syauqi-alias/pico-peltier/README.md

# pico-peltier
A TEC Controller using Pico RP2350 with Analog Devices LT8722 full bridge driver rated at 15V 4A

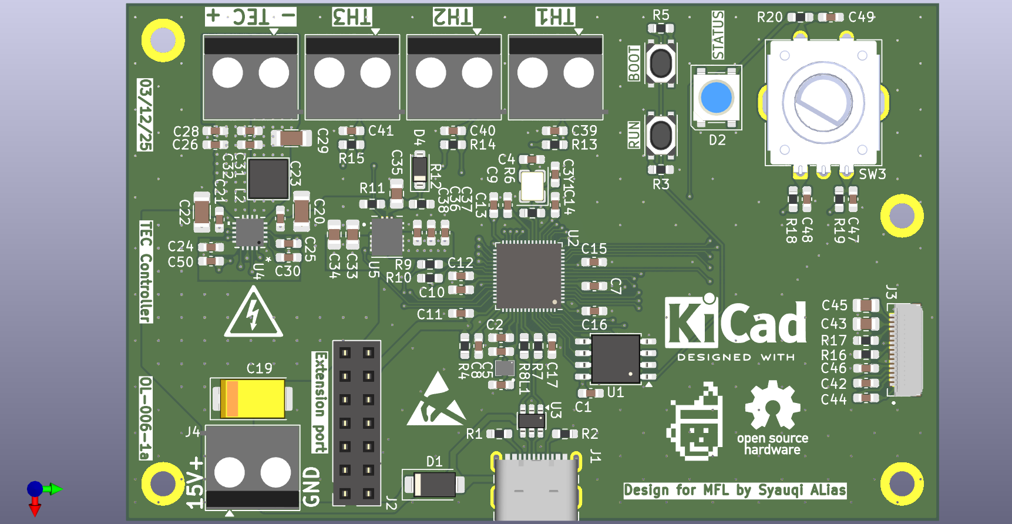
[picture p1: pico_peltier.png]
}Prototype rendered
