syauqi-alias/pico-peltier/analog device demo dc3145a/715-DC3145A_REV3_WEB_BOM.XLSX

 |  |  | DEMO BOARD DC3145A
REQUIRED CIRCUIT COMPONENTS
ITEM | QTY | REFERENCE | DESCRIPTION | SUGGESTED MANUFACTURER, P/N | BOM Notes
1 | 2 | CIN1,CIN2 | CAP.,22uF,ALUM,25V,20%,SMD 6.3x5.8mm | Wurth/875105544003
2 | 1 | C1 | CAP.,47uF,TANT.,20V,20%,7343,TAJD, NO SUBS. ALLOWED | AVX/TAJD476M020RNJ
3 | 4 | C2,CIN3,C9,C15 | CAP.,4.7uF,X7R,25V,10%,1206 | AVX/12063C475KAT2A MURATA/GRM31CR71E475KA88L NIC/NMC1206X7R475K25TRPF TAIYO YUDEN/TMK316AB7475KL-T
4 | 2 | C3,C8 | CAP.,0.1uF,X5R,25V,10%,0402 | AVX/04023D104KAT2A SAMSUNG/CL05A104KA5NNNC TDK/C1005X5R1E104K050BC
5 | 3 | C4,CIN4,C5 | CAP.,1uF,X7R,25V,10%,0603,AEC-Q200 | MURATA/GCM188R71E105KA64D
6 | 1 | C10 | CAP.,0.1uF,X7R,25V,10%,0603,AEC-Q200 | AVX/06033C104K4T4A SAMSUNG/CL10B104KA8WPNC
7 | 1 | C11 | CAP.,1000pF,X7R,25V,10%,0603 | AVX/06033C102KAT2A AVX/06033C102KAT4A KEMET/C0603C102K3RACTU MURATA/GRM188R71E102KA01D NIC/NMC0603X7R102K25TRPF
8 | 3 | C12,C13,C14 | CAP.,0.047uF,X7R,25V,10%,0603 | AVX/06033C473KAT2A MURATA/GRM188R71E473KA01D NIC/NMC0603X7R473K25TRPF
9 | 1 | LB1 | LABEL SPEC, DEMO BOARD SERIAL NUMBER | BRADY/THT-96-717-10
10 | 1 | L1 | IND.,1.0uH,POWER,20%,12A,9.0mOHMS,4.3mmX4.3mm,AEC-Q200 | COILCRAFT/XGL4020-102MEC
11 | 1 | PCB1 | PCB, DC3145A | ADI APPROVED SUPPLIER/600-DC3145A
12 | 1 | R1 | RES.,1k OHM,5%,1/10W,0603,AEC-Q200 | VISHAY/CRCW06031K00JNEA
13 | 1 | R2 | RES.,10 OHMS,5%,1/10W,0603,AEC-Q200 | PANASONIC/ERJ3GEYJ100V VISHAY/CRCW060310R0JNEA
14 | 1 | R3 | RES.,20k OHMS,1%,1/10W,0603 | NIC/NRC06F2002TRF PANASONIC/ERJ3EKF2002V VISHAY/CRCW060320K0FKEA YAGEO/RC0603FR-0720KL
15 | 2 | R5,R6 | RES.,100k OHMS,5%,1/10W,0603,AEC-Q200 | NIC/NRC06J104TRF
16 | 1 | STNCL1 | TOOL, STENCIL, 700-DC3145A | ADI APPROVED SUPPLIER/830-DC3145A
17 | 1 | U1 | IC,15V, 4A MONOLITHIC THERMOELECTRIC COOLER CONTROLLER | ANALOG DEVICES/LT8722AV#PBF
18 | 2 | XJP1,XJP2 | CONN.,SHUNT,FEMALE,2 POS,2mm | Wurth/60800213421
ADDITIONAL DEMO BOARD CIRCUIT COMPONENTS
ITEM | QTY | REFERENCE | DESCRIPTION | SUGGESTED MANUFACTURER, P/N | BOM Notes
1 | 0 | CIN5,C7,C16,C17 | CAP., OPTION, 0603
2 | 0 | D1,D2 | DIODE, OPTION, SOD-323
3 | 0 | R4 | RES.,100 OHMS,5%,5W,20.47mm X 10.31mm | OHMITE/RW5S0FA100RJE
4 | 0 | R7 | RES., OPTION, 0603
HARDWARE
ITEM | QTY | REFERENCE | DESCRIPTION | SUGGESTED MANUFACTURER, P/N | BOM Notes
1 | 6 | E1,E2,E3,E4,E5,E6 | TEST POINT,TURRET,0.094" MTG. HOLE,PCB 0.062" THK | MILL-MAX/2501-2-00-80-00-00-07-0
2 | 15 | E7,E8,E9,E10,E11,E12,E13,E14,E15,E16,E17,E18,E19,E20,E21 | TEST POINT,SILVER PLATE,PHOSPHOR BRONZE,3.81mmX2.03mm,2.29mm H,SMT | KEYSTONE/5019
3 | 4 | J1,J2,J3,J4 | CONN.,BANANA JACK,FEMALE,THT,NON-INSULATED,SWAGE,0.218" | KEYSTONE/575-4
4 | 2 | JP1,JP3 | CONN.,HDR,MALE,1x3,2mm,VERT,ST,THT,NO SUBS. ALLOWED | Wurth/62000311121
5 | 1 | JP2 | CONN.,HDR,SHROUDED,PLUG,MALE,2x7,2mm,VERT,ST,THT,KEYED | MOLEX/87831-1420
6 | 4 | MP1,MP2,MP3,MP4 | STANDOFF,NYLON,SNAP-ON,0.50" | KEYSTONE/8833
