syauqi-alias/pico-peltier/pico_peltier_mouser.xls

Mfr Part Number (Input) | Manufacturer Part Number | Mouser Part Number | Manufacturer Name | Description | Quantity 1 | Unit Price 1 | Quantity 2 | Unit Price 2 | Quantity 3 | Unit Price 3 | Quantity 4 | Unit Price 4 | Quantity 5 | Unit Price 5 | Order Quantity | Order Unit Price | Min./Mult. | Availability | Lead Time in Days | Lifecycle | NCNR | RoHS | Pb Free | Package Type | Datasheet URL | Product Image | Design Risk
 |  | 581-KGM15AR70J104KM |  |  | 18
 |  | 81-GRM188Z71A475KE5D |  |  | 4
 |  | 603-CC603FRNPO9BN150 |  |  | 2
 |  | 581-TAJD476M020R |  |  | 1
 |  | 581-12063C475KAT2A |  |  | 3
 |  | 187-CL10A104KA8NNNC |  |  | 6
 |  | 81-GCJ188R71E473KA1D |  |  | 3
 |  | 81-GCM188R71E105KA4D |  |  | 2
 |  | 187-CL21A106KAYNNNE |  |  | 1
 |  | 581-08053D104KAT2A |  |  | 1
 |  | KGM21NR71E103KT |  |  | 1
 |  | 581-KAM15CT70J226KT |  |  | 2
 |  | 81-GCM188R71E105KA4D |  |  | 2
 |  | 187-CL21A106KAYNNNE |  |  | 2
 |  | 625-SS12-E3 |  |  | 1
 |  | 474-COM-24837 |  |  | 1
 |  | 640-USB4105-GF-A |  |  | 1
 |  | 571-5-534236-7 |  |  | 1
 |  | 649-311A7H121016E200 |  |  | 1
 |  | 845-30.002 |  |  | 2
 |  | 815-AB201610S3R3101T |  |  | 1
 |  | 994-XAL4020-102MEC |  |  | 1
 |  | 652-CR0603FX-5101ELF |  |  | 3
 |  | 603-RC0603FR-101KL |  |  | 3
 |  | 279-CRGCQ0603F33R |  |  | 1
 |  | 603-RC0603FR-1327RL |  |  | 2
 |  | 71-CRCW0603-20K-E3 |  |  | 1
 |  | 660-SG73P1JTTD1003F |  |  | 1
 |  | 667-ERJ-3EKF8662V |  |  | 1
 |  | 71-CRCW060310K0FKEE |  |  | 4
 |  | 603-RT0603WRE0710KL |  |  | 3
 |  | 71-CRCW0603680KFKEAH |  |  | 1
 |  | 710-434133025816 |  |  | 2
 |  | 652-PEC12R3220FS0024 |  |  | 1
 |  | 845-30.002 |  |  | 3
 |  | 454-W25Q128JVSIMTR |  |  | 1
 |  | 358-SC1509 |  |  | 1
 |  | 710-82400102 |  |  | 1
 |  | 584-LT8722AVPBF |  |  | 1
 |  | 595-TPSM863253RDXR |  |  | 1
 |  | 815-ABM8-272-T3 |  |  | 1
