syauqi-alias/pico-peltier/plots/pico_peltier__Assembly.pdf

J3 | H1 U5 C36 1 | 2 | 3 | 4 | 5 | 6 1 | 2 | 3 | 4 | 5 | 6 ABCD | ABCD Date: KiCad E.D.A. 9.0.6 Size: A4 | Rev:

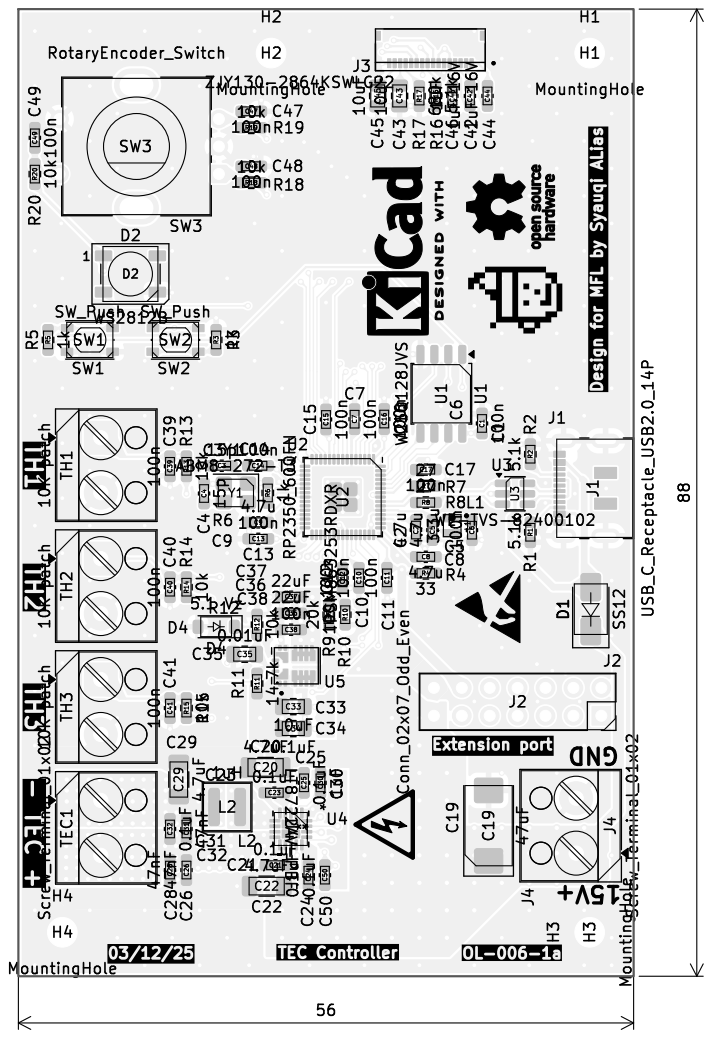
[picture p2: page 1]

Id: /1 Title: File: pico_peltier.kicad_pcb Sheet: Black And White TOP

1 | 2 | 3 | 4 | 5 | 6

A

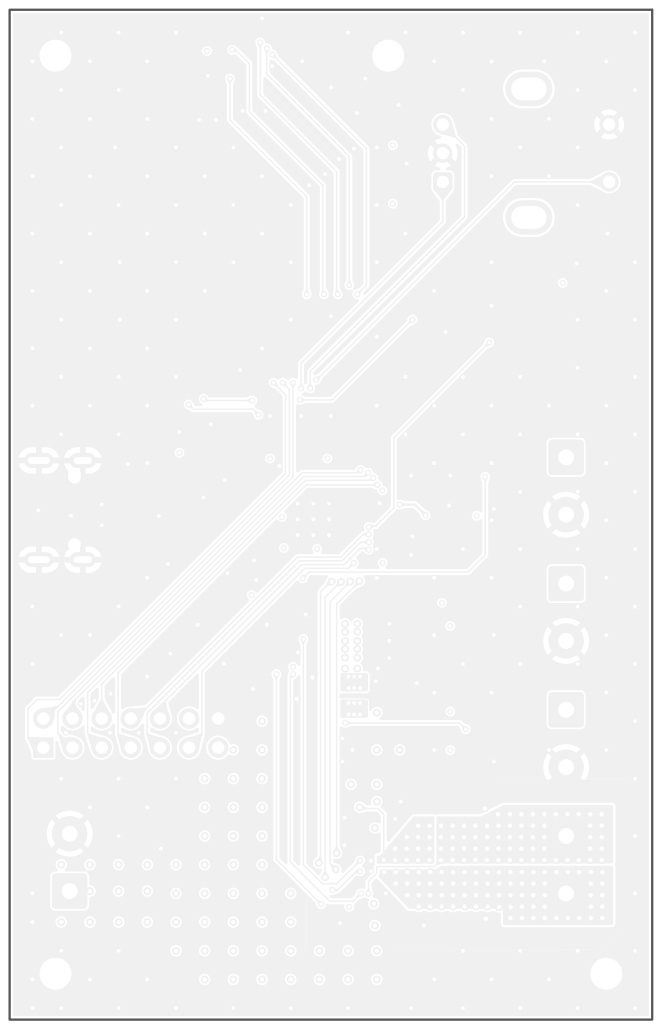
[picture p3: page 2]
D Date: KiCad; E.D.A. 9.0.6 Size: A4; Rev:; Id: /1 Title: File: pico_peltier.kicad_pcb Sheet: Black; And; White; BOT Board2Pdf:; Black; BOT -; Page 2/2
