syauqi-alias/pico-peltier/analog device demo dc3145a/705-DC3145A_REV3_PCA_ASSY_DWG_BOTTOM.PDF

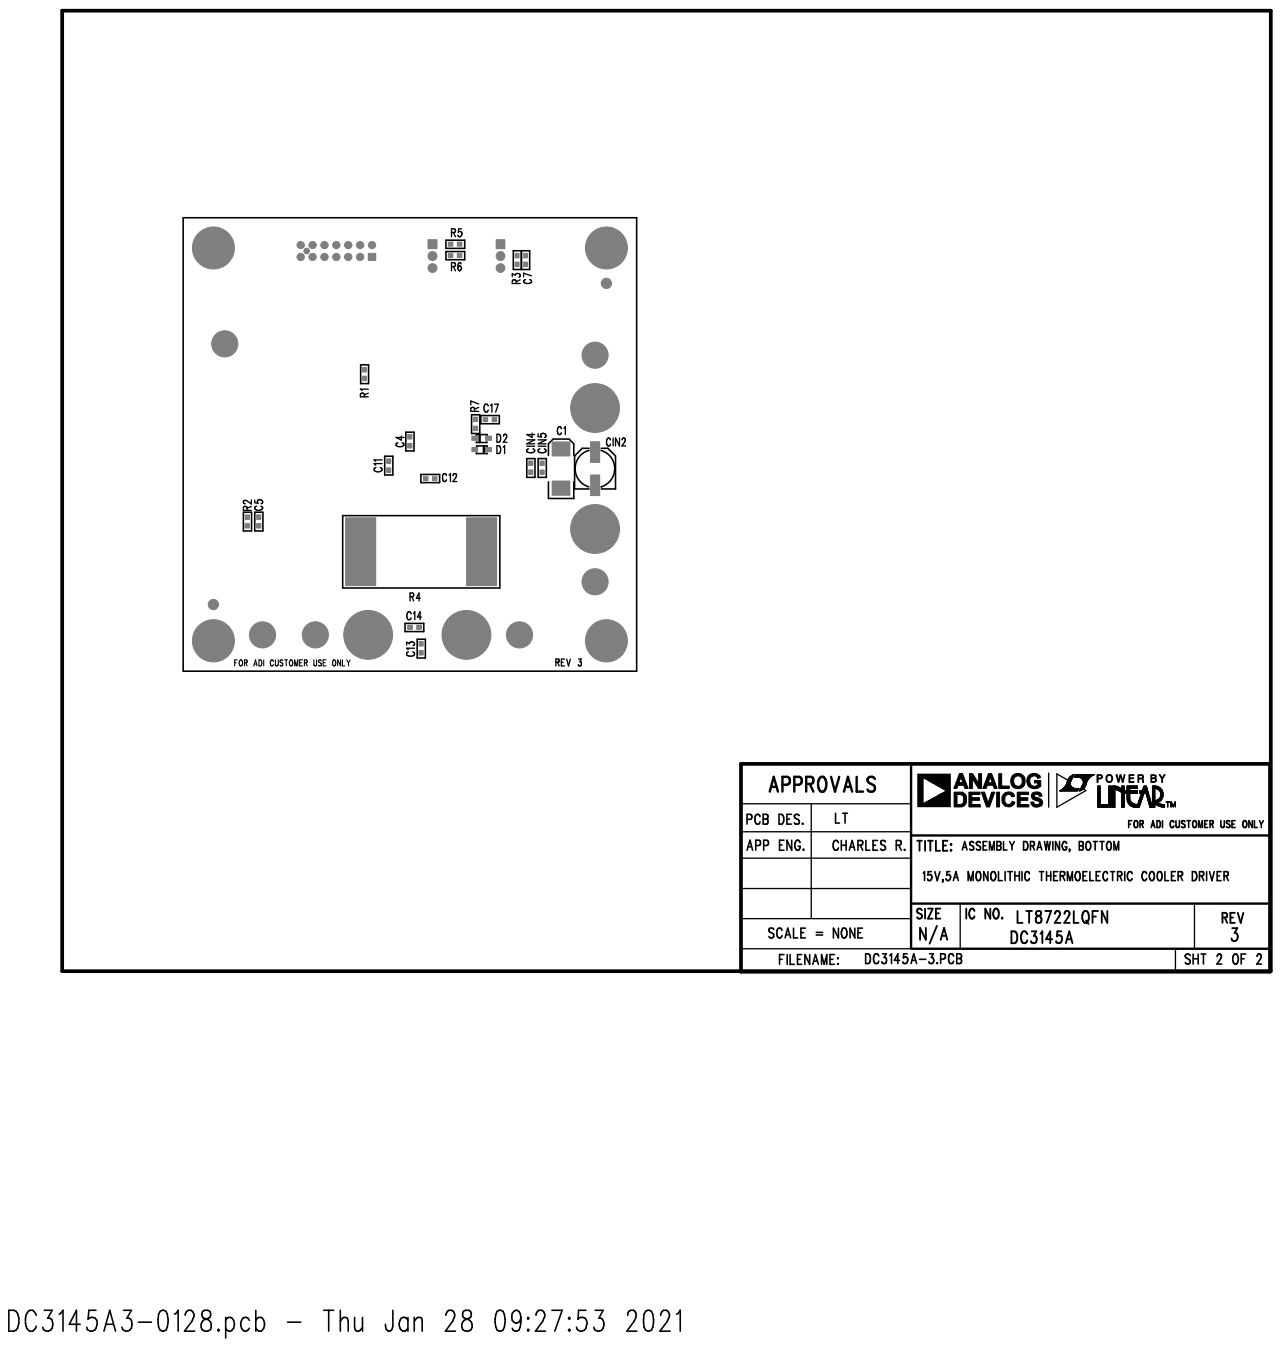
[picture p11: page 1]
