syauqi-alias/pico-peltier/analog device demo dc3145a/705-DC3145A_REV3_PCA_ASSY_DWG_TOP.PDF

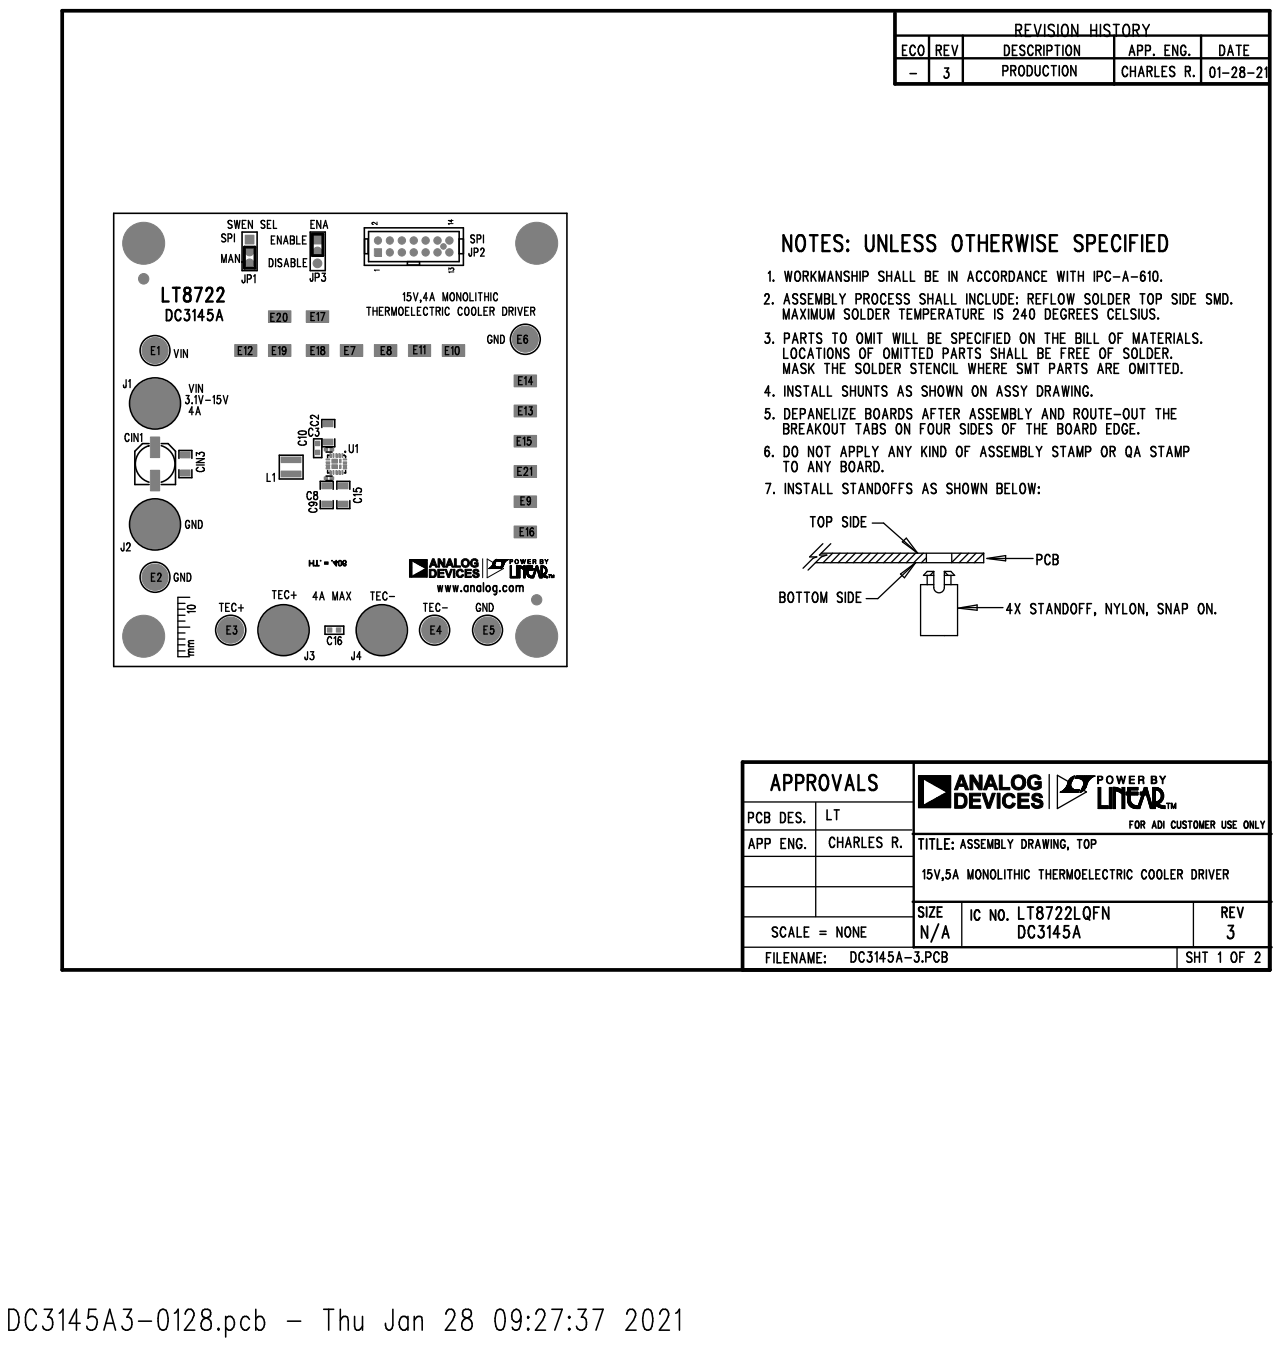
[picture p12: page 1]
