syauqi-alias/pico-peltier/analog device demo dc3145a/610-DC3145A_REV3_GERBER_PDF/DC3145A3-BM.pdf

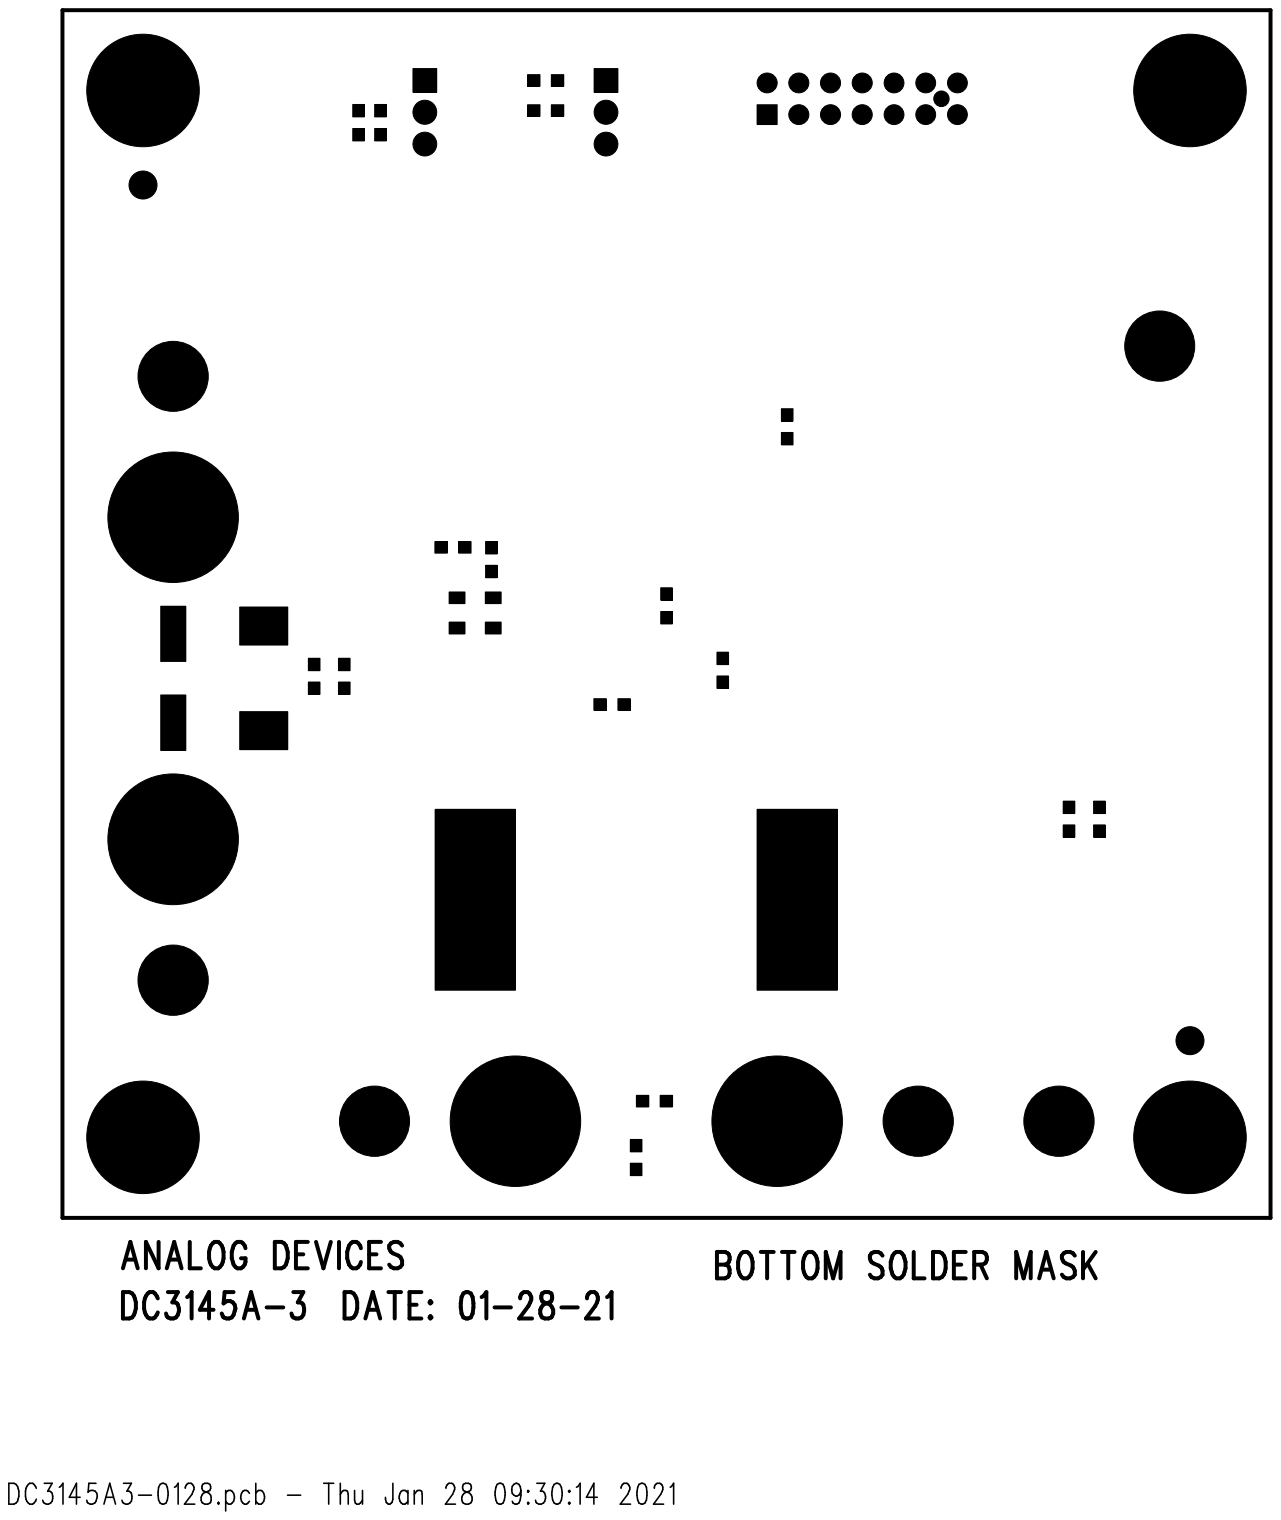
[picture p13: page 1]
