syauqi-alias/pico-peltier/analog device demo dc3145a/610-DC3145A_REV3_GERBER_PDF/DC3145A3-BP.pdf

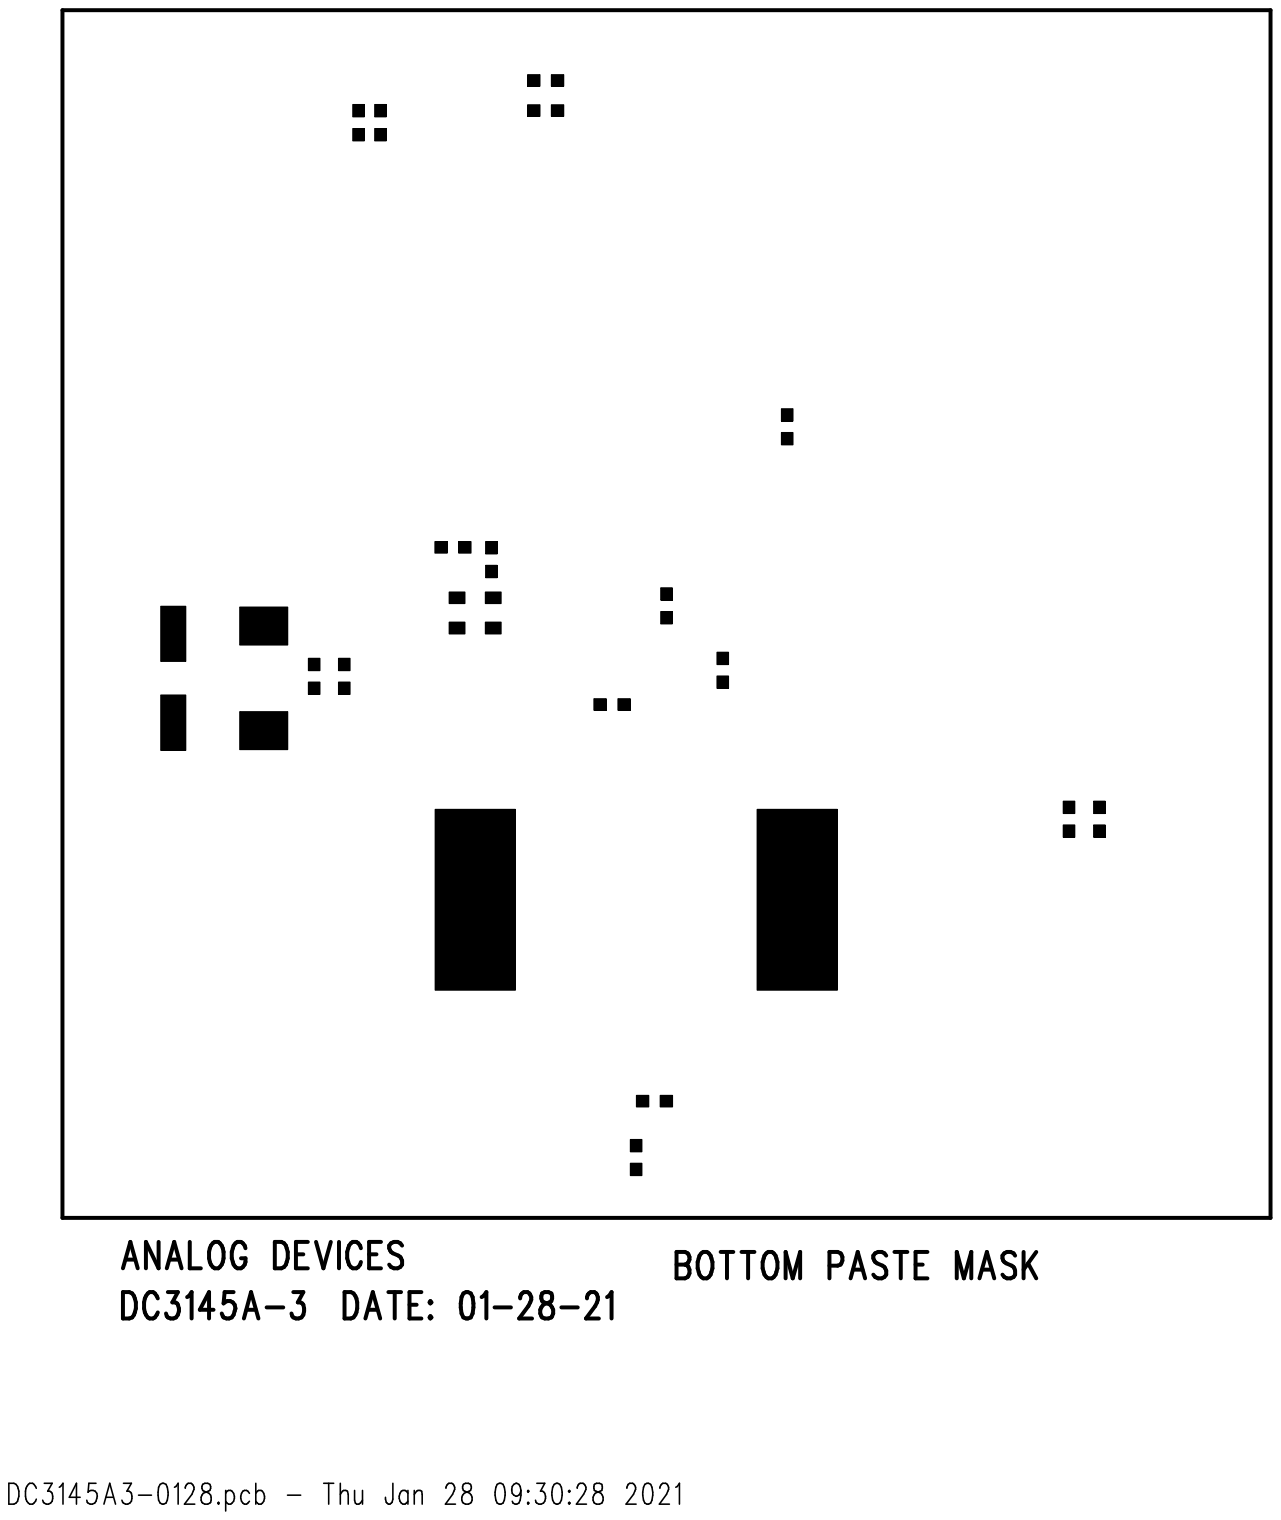
[picture p14: page 1]
