syauqi-alias/pico-peltier/analog device demo dc3145a/610-DC3145A_REV3_GERBER_PDF/DC3145A3-BS.pdf

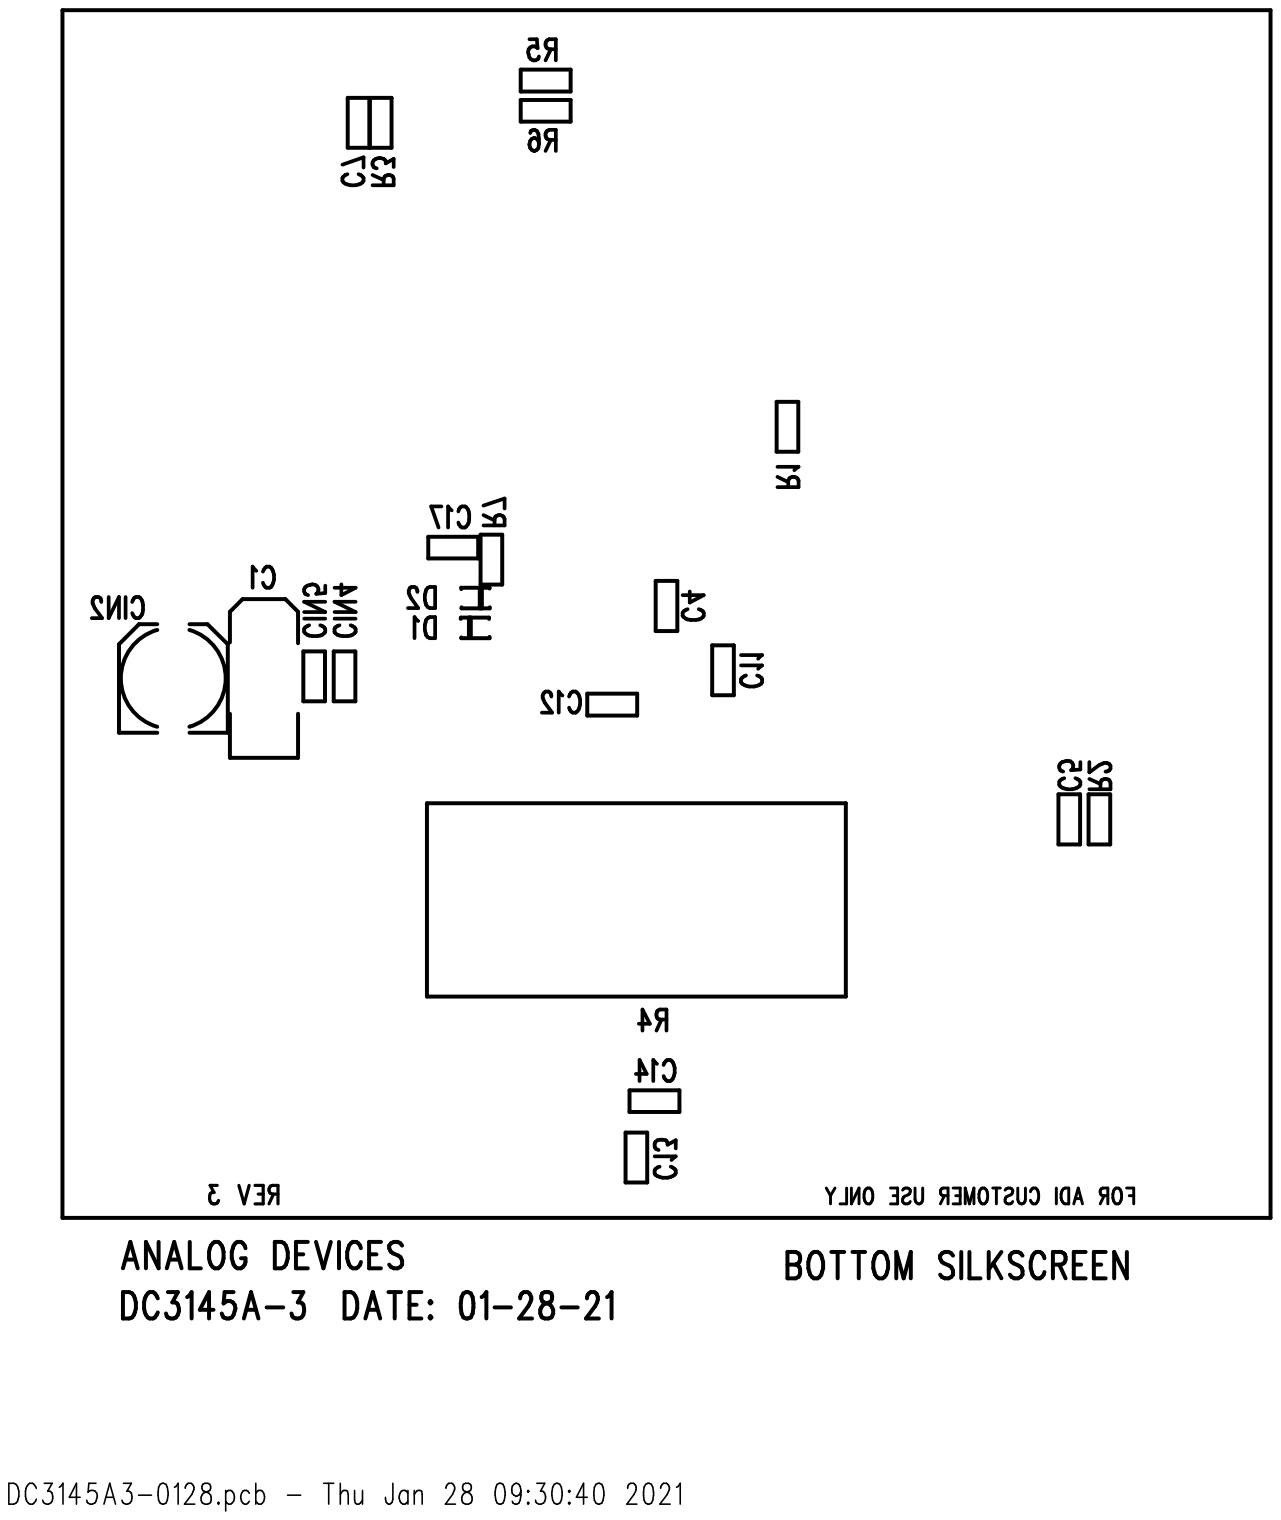
[picture p15: page 1]
