syauqi-alias/pico-peltier/(list of files, drawings)

Other design files:
analog device demo dc3145a/630-DC3145A_REV3_DESIGN_LAYOUT.PCB
analog device demo dc3145a/710-DC3145A_REV3_PCA_SCHEMATIC.DSN
