syauqi-alias/pico-peltier/pico_peltier.kicad_pcb

## KiCad design pico_peltier.kicad_pcb (2025-12-16)

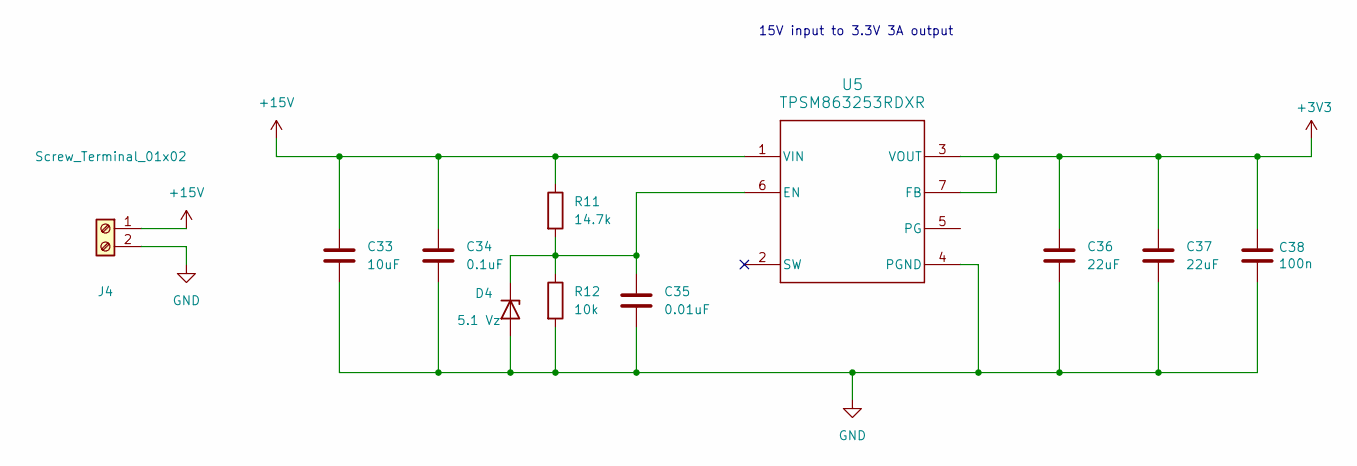
[picture p24: schematic 3v3_psu.kicad_sch, 3.3V Power Supply]

Parts:
C33: 10uF; C_0805_2012Metric_Pad1.18x1.45mm_HandSolder; mouser 187-CL21A106KAYNNNE
C34: 0.1uF; C_0805_2012Metric_Pad1.18x1.45mm_HandSolder; mouser 581-08053D104KAT2A
C35: 0.01uF; C_0805_2012Metric_Pad1.18x1.45mm_HandSolder; mouser KGM21NR71E103KT
C36, C37: 22uF; C_0603_1608Metric_Pad1.08x0.95mm_HandSolder; mouser 581-KAM15CT70J226KT
C38: 100n; C_0603_1608Metric_Pad1.08x0.95mm_HandSolder; mouser 581-KGM15AR70J104KM
D4: 5.1 Vz; D_SOD-123; mouser 621-MMSZ5231B-F
J4: Screw_Terminal_01x02; Altech_AK100_1x02_P5.00mm; mouser 845-30.002
R11: 14.7k; R_0603_1608Metric_Pad0.98x0.95mm_HandSolder; mouser 603-RC0603FR-1014K7L
R12: 10k; R_0603_1608Metric_Pad0.98x0.95mm_HandSolder; mouser 71-CRCW060310K0FKEE
U5: TPSM863253RDXR; VREG_TPSM863253RDXR; mouser 595-TPSM863253RDXR

Connections:
+3V3: C36.1, C37.1, C38.1, U5.3 (VOUT), U5.7 (FB), U5.14 (VOUT), U5.15 (VOUT), U5.16 (VOUT), U5.17 (VOUT), U5.18 (VOUT), U5.19 (VOUT); also elsewhere on the board
+15V: C33.1, C34.1, J4.1, R11.1, U5.1 (VIN); also elsewhere on the board
GND: C33.2, C34.2, C35.2, C36.2, C37.2, C38.2, D4.2 (A), J4.2, R12.2, U5.4 (PGND); also elsewhere on the board
unnamed: C35.1, D4.1 (K), R11.2, R12.1, U5.6 (EN)

Notes on the sheet:
15V input to 3.3V 3A output

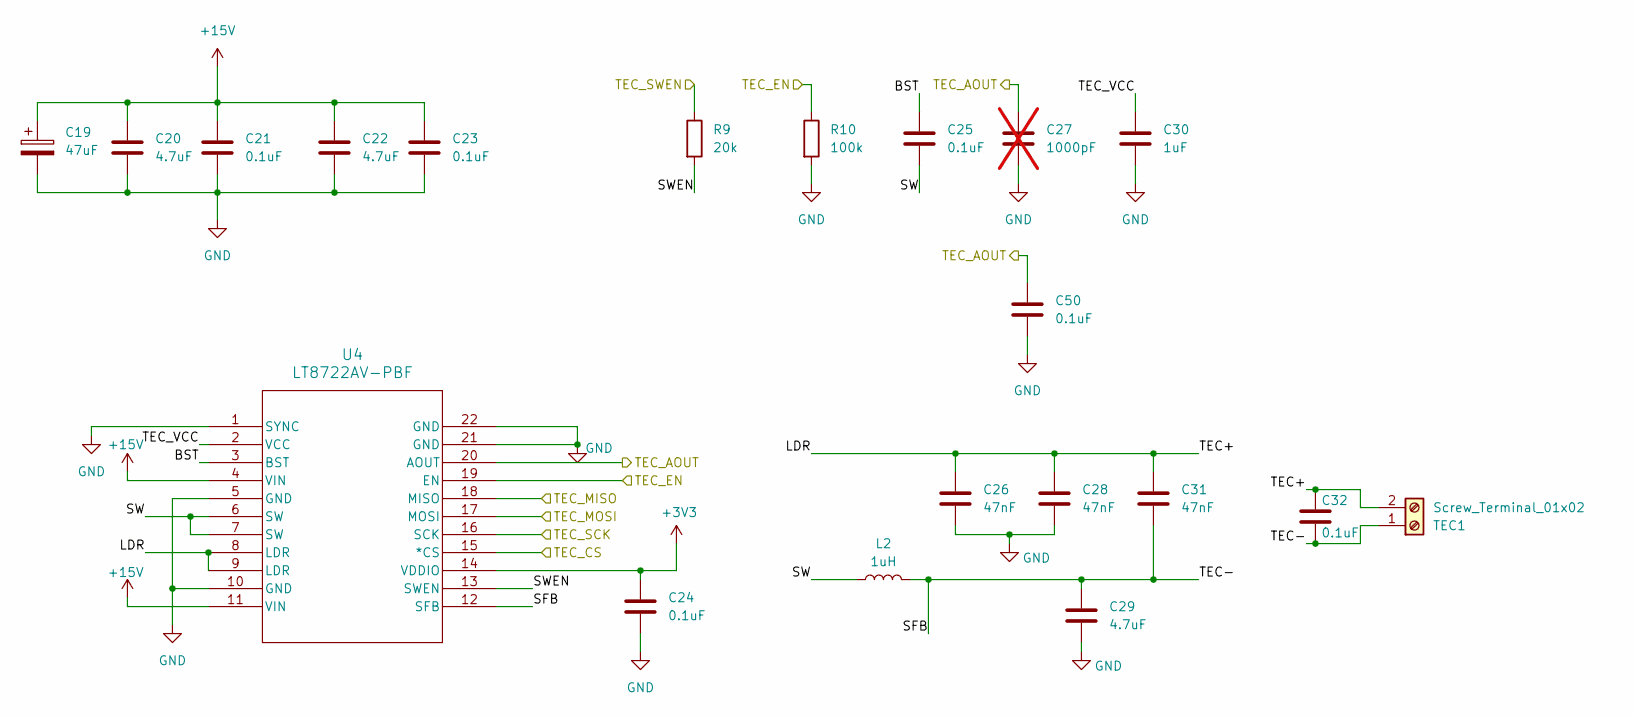
[picture p25: schematic peltier_cont.kicad_sch, LT8722 Half Bridge Driver]

Parts:
C19: 47uF; CP_EIA-7343-31_Kemet-D_HandSolder; mouser 581-TAJD476M020R
C20, C22, C29: 4.7uF; C_1206_3216Metric_Pad1.33x1.80mm_HandSolder; mouser 581-12063C475KAT2A
C21, C23, C24, C25, C32, C50: 0.1uF; C_0603_1608Metric_Pad1.08x0.95mm_HandSolder; mouser 187-CL10A104KA8NNNC
C26, C28, C31: 47nF; C_0603_1608Metric_Pad1.08x0.95mm_HandSolder; mouser 81-GCJ188R71E473KA1D
C27: 1000pF; C_0603_1608Metric_Pad1.08x0.95mm_HandSolder; mouser 581-06033C102KAT2A; not fitted
C30: 1uF; C_0603_1608Metric_Pad1.08x0.95mm_HandSolder; mouser 81-GCM188R71E105KA4D
L2: 1uH; L_Coilcraft_XAL4020-XXX; mouser 994-XAL4020-102MEC
R9: 20k; R_0603_1608Metric_Pad0.98x0.95mm_HandSolder; mouser 71-CRCW0603-20K-E3
R10: 100k; R_0603_1608Metric_Pad0.98x0.95mm_HandSolder; mouser 660-SG73P1JTTD1003F
TEC1: Screw_Terminal_01x02; Altech_AK100_1x02_P5.00mm; mouser 845-30.002
U4: LT8722AV-PBF; LQFN18_3X3X0.95_ADI-M; mouser 584-LT8722AVPBF

Connections:
+3V3: C24.1, U4.14 (VDDIO); also elsewhere on the board
+15V: C19.1, C20.1, C21.1, C22.1, C23.1, U4.4 (VIN), U4.11 (VIN); also elsewhere on the board
/mcu_rp2354a/GPIO20: U4.18 (MISO); also elsewhere on the board
/mcu_rp2354a/GPIO21: U4.16 (SCK); also elsewhere on the board
/mcu_rp2354a/GPIO22: U4.15 (*CS); also elsewhere on the board
/mcu_rp2354a/GPIO23: U4.17 (MOSI); also elsewhere on the board
/mcu_rp2354a/GPIO24: R9.1; also elsewhere on the board
/mcu_rp2354a/GPIO25: R10.1, U4.19 (EN); also elsewhere on the board
/mcu_rp2354a/GPIO29_ADC3: C27.1, C50.1, U4.20 (AOUT); also elsewhere on the board
/peltier_cont/BST: C25.1, U4.3 (BST)
/peltier_cont/LDR: C26.1, C28.1, C31.1, C32.1, TEC1.2, U4.8 (LDR), U4.9 (LDR)
/peltier_cont/SFB: C29.1, C31.2, C32.2, L2.2, TEC1.1, U4.12 (SFB)
/peltier_cont/SW: C25.2, L2.1, U4.6 (SW), U4.7 (SW)
/peltier_cont/SWEN: R9.2, U4.13 (SWEN)
/peltier_cont/TEC_VCC: C30.1, U4.2 (VCC)
GND: C19.2, C20.2, C21.2, C22.2, C23.2, C24.2, C26.2, C27.2, C28.2, C29.2, C30.2, C50.2, R10.2, U4.1 (SYNC), U4.5 (GND), U4.10 (GND), U4.21 (GND), U4.22 (GND); also elsewhere on the board

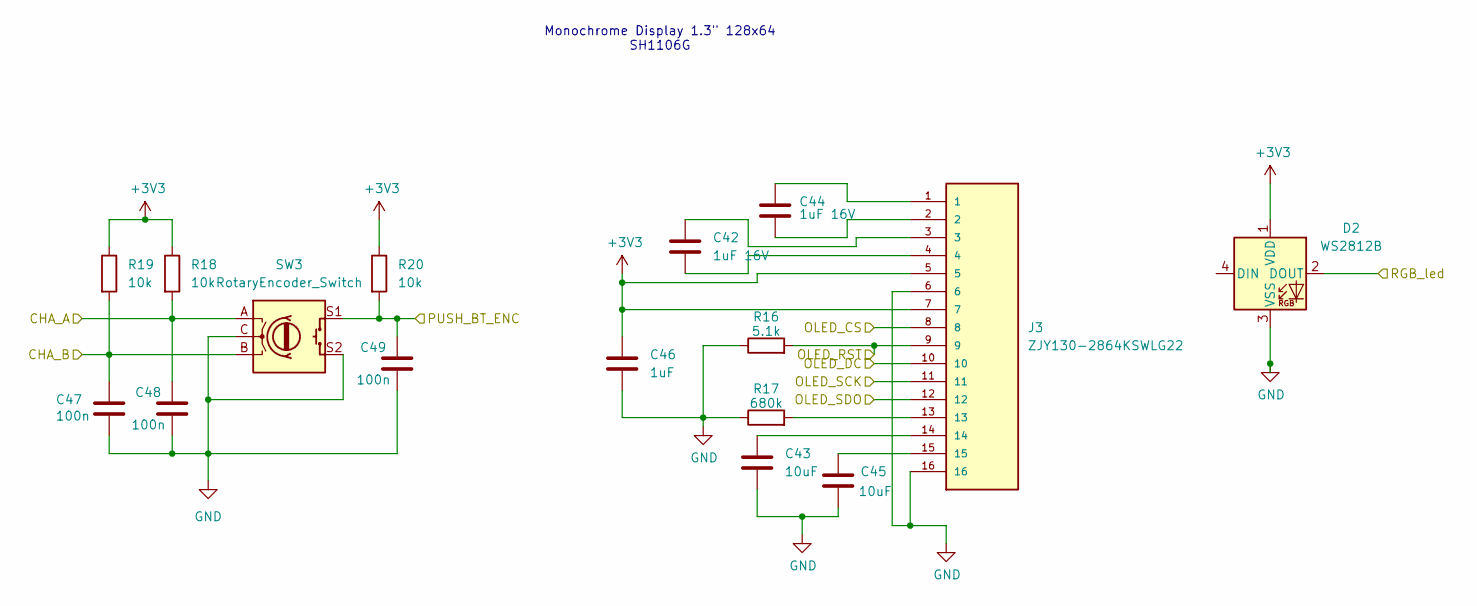
[picture p26: schematic display.kicad_sch, Display and Encoder]

Parts:
C42, C44: 1uF 16V; C_0603_1608Metric_Pad1.08x0.95mm_HandSolder; mouser 81-GCM188R71E105KA4D
C43, C45: 10uF; C_0805_2012Metric; mouser 187-CL21A106KAYNNNE
C46: 1uF; C_0603_1608Metric_Pad1.08x0.95mm_HandSolder; mouser 81-GCM188R71E105KA4D
C47, C48, C49: 100n; C_0603_1608Metric_Pad1.08x0.95mm_HandSolder; mouser 581-KGM15AR70J104KM
D2: WS2812B; LED_WS2812B_PLCC4_5.0x5.0mm_P3.2mm; mouser 474-COM-24837
J3: ZJY130-2864KSWLG22; AMPHENOL_F3311A7H121016E200; MPN F3311A7H121016E200; mouser 649-311A7H121016E200
R16: 5.1k; R_0603_1608Metric_Pad0.98x0.95mm_HandSolder; MPN CR0603-FX-5101ELF; mouser 652-CR0603FX-5101ELF
R17: 680k; R_0603_1608Metric_Pad0.98x0.95mm_HandSolder; MPN CRCW0603680KFKEAHP; mouser 71-CRCW0603680KFKEAH
R18, R19, R20: 10k; R_0603_1608Metric_Pad0.98x0.95mm_HandSolder; mouser 71-CRCW060310K0FKEE
SW3: RotaryEncoder_Switch; RotaryEncoder_Bourns_Vertical_PEC12R-3x17F-Sxxxx; mouser 652-PEC12R3220FS0024

Connections:
+3V3: C46.1, D2.1 (VDD), J3.5, J3.7, R18.1, R19.1, R20.1; also elsewhere on the board
/display/CHA_A: C48.1, R18.2, SW3.A; also elsewhere on the board
/display/CHA_B: C47.1, R19.2, SW3.B; also elsewhere on the board
/display/OLED_CS: J3.8; also elsewhere on the board
/display/OLED_DC: J3.10; also elsewhere on the board
/display/OLED_RST: J3.9, R16.2; also elsewhere on the board
/display/OLED_SCK: J3.11; also elsewhere on the board
/display/OLED_SDO: J3.12; also elsewhere on the board
/display/PUSH_BT_ENC: C49.1, R20.2, SW3.S1; also elsewhere on the board
/display/RGB_led: D2.2 (DOUT); also elsewhere on the board
GND: C43.2, C45.2, C46.2, C47.2, C48.2, C49.2, D2.3 (VSS), J3.6, J3.16, R16.1, R17.1, SW3.C, SW3.S2; also elsewhere on the board
unnamed: C42.1, J3.3
unnamed: C42.2, J3.4
unnamed: C43.1, J3.14
unnamed: C44.1, J3.1
unnamed: C44.2, J3.2
unnamed: C45.1, J3.15
unnamed: J3.13, R17.2

Notes on the sheet:
Monochrome Display 1.3" 128x64 SH1106G

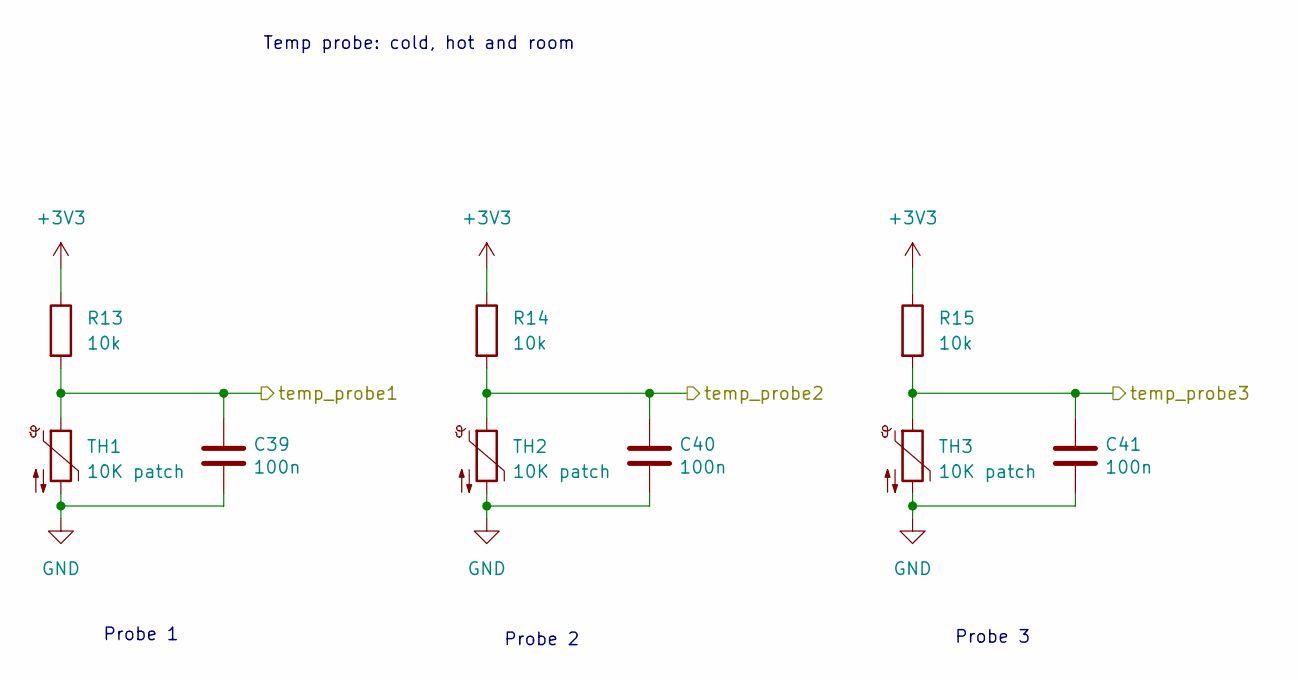
[picture p27: schematic temp_probe.kicad_sch, NTC 10K Probe]

Parts:
C39, C40, C41: 100n; C_0603_1608Metric_Pad1.08x0.95mm_HandSolder; mouser 581-KGM15AR70J104KM
R13, R14, R15: 10k; R_0603_1608Metric_Pad0.98x0.95mm_HandSolder; mouser 603-RT0603WRE0710KL
TH1, TH2, TH3: 10K patch; Altech_AK100_1x02_P5.00mm; mouser 845-30.002

Connections:
+3V3: R13.1, R14.1, R15.1; also elsewhere on the board
/mcu_rp2354a/GPIO26_ADC0: C39.1, R13.2, TH1.1; also elsewhere on the board
/mcu_rp2354a/GPIO27_ADC1: C40.1, R14.2, TH2.1; also elsewhere on the board
/mcu_rp2354a/GPIO28_ADC2: C41.1, R15.2, TH3.1; also elsewhere on the board
GND: C39.2, C40.2, C41.2, TH1.2, TH2.2, TH3.2; also elsewhere on the board

Notes on the sheet:
Temp probe: cold, hot and room
Probe 1
Probe 2
Probe 3

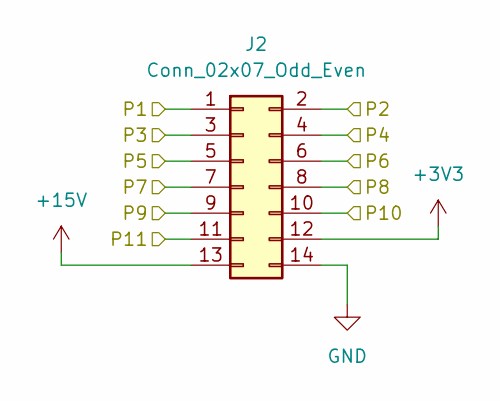
[picture p28: schematic pinout.kicad_sch, Extension Port]

Parts:
J2: Conn_02x07_Odd_Even; PinSocket_2x07_P2.54mm_Vertical; mouser 571-5-534236-7

Connections:
+3V3: J2.12; also elsewhere on the board
+15V: J2.13; also elsewhere on the board
/mcu_rp2354a/GPIO0: J2.1; also elsewhere on the board
/mcu_rp2354a/GPIO1: J2.2; also elsewhere on the board
/mcu_rp2354a/GPIO2: J2.3; also elsewhere on the board
/mcu_rp2354a/GPIO12: J2.4; also elsewhere on the board
/mcu_rp2354a/GPIO13: J2.5; also elsewhere on the board
/mcu_rp2354a/GPIO14: J2.6; also elsewhere on the board
/mcu_rp2354a/GPIO15: J2.7; also elsewhere on the board
/mcu_rp2354a/GPIO16: J2.8; also elsewhere on the board
/mcu_rp2354a/GPIO17: J2.9; also elsewhere on the board
/mcu_rp2354a/GPIO18: J2.10; also elsewhere on the board
/mcu_rp2354a/GPIO19: J2.11; also elsewhere on the board
GND: J2.14; also elsewhere on the board

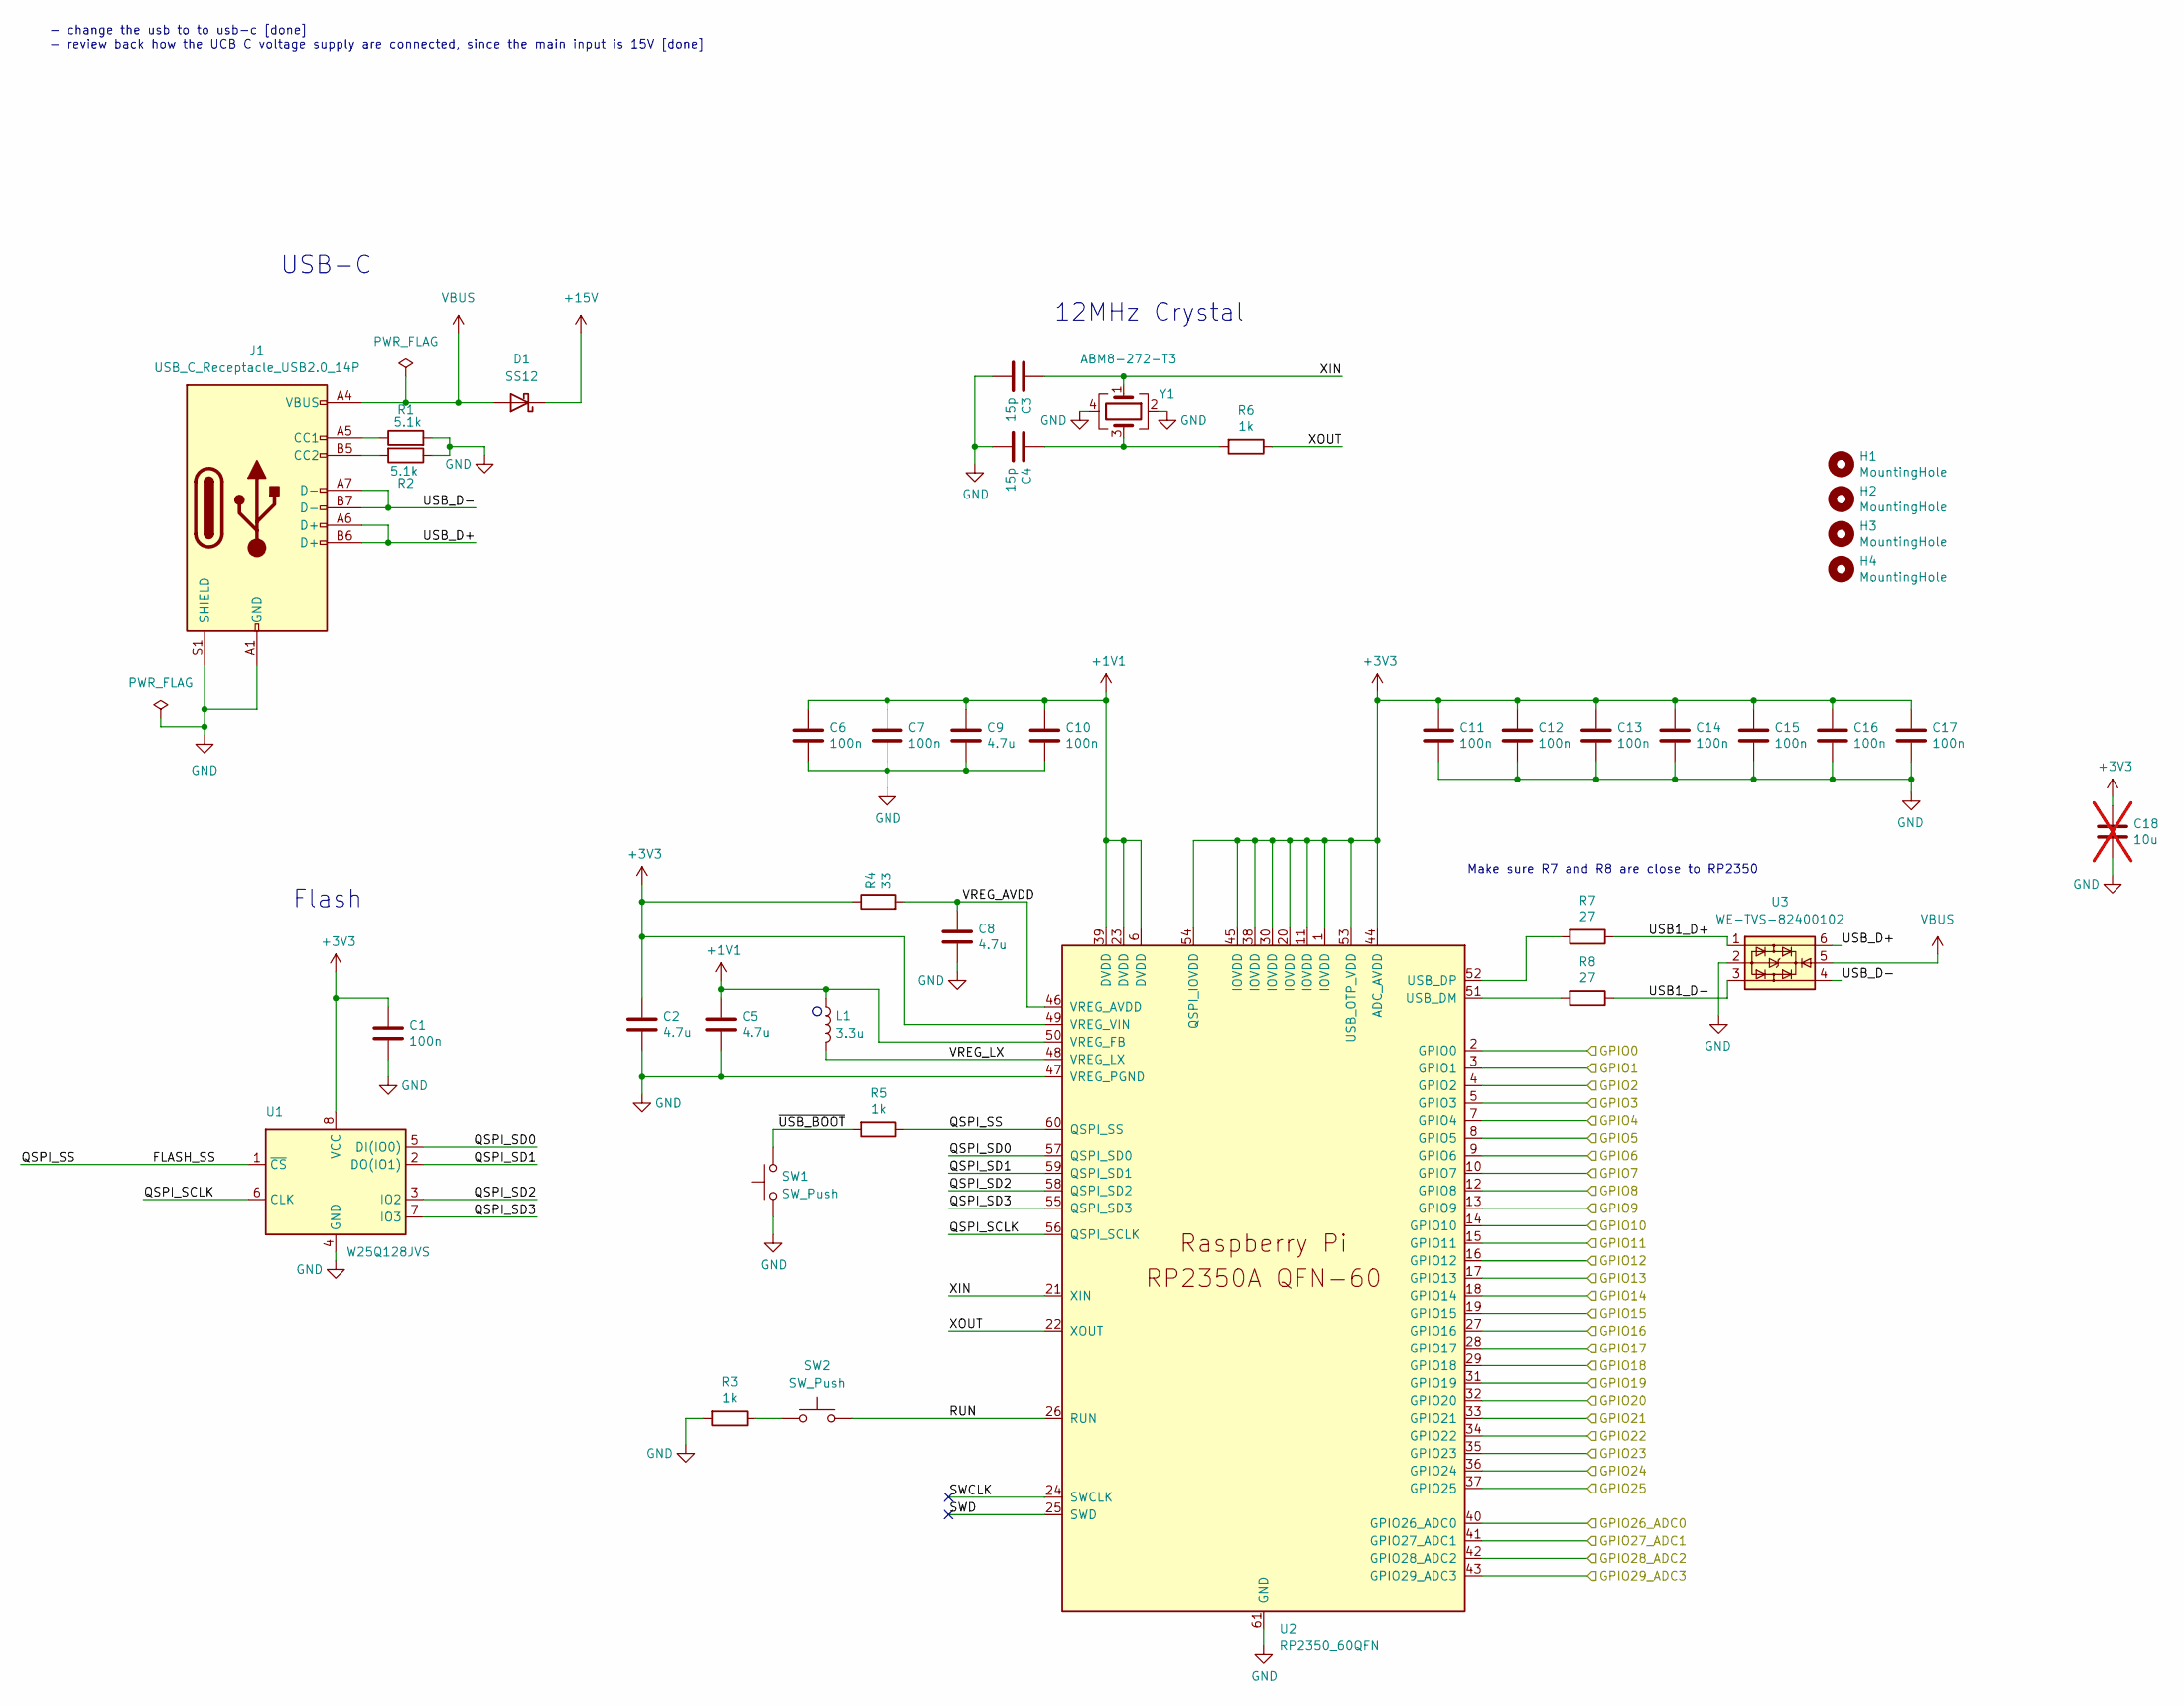
[picture p29: schematic mcu_rp2354a.kicad_sch, RP2350 MCU]

Parts:
C1, C6, C7, C10, C11, C12, C13, C14, C15, C16, C17: 100n; C_0603_1608Metric_Pad1.08x0.95mm_HandSolder; mouser 581-KGM15AR70J104KM
C2, C5, C8, C9: 4.7u; C_0603_1608Metric_Pad1.08x0.95mm_HandSolder; mouser 81-GRM188Z71A475KE5D
C3, C4: 15p; C_0603_1608Metric_Pad1.08x0.95mm_HandSolder; mouser 603-CC603FRNPO9BN150
C18: 10u; C_0805_2012Metric; not fitted
D1: SS12; D_SMA; MPN SS12; mouser 625-SS12-E3
H1, H2, H3, H4: MountingHole; MountingHole_2.7mm_M2.5_DIN965_Pad_TopBottom
J1: USB_C_Receptacle_USB2.0_14P; USB_C_Receptacle_JAE_DX07S016JA1R1500; LCSC TYPE-C-31-M-12
L1: 3.3u; L_pol_2016; mouser 815-AB201610S3R3101T
R1, R2: 5.1k; R_0603_1608Metric_Pad0.98x0.95mm_HandSolder; MPN CR0603-FX-5101ELF; mouser 652-CR0603FX-5101ELF
R3, R5, R6: 1k; R_0603_1608Metric_Pad0.98x0.95mm_HandSolder; mouser 603-RC0603FR-101KL
R4: 33; R_0603_1608Metric_Pad0.98x0.95mm_HandSolder; mouser 279-CRGCQ0603F33R
R7, R8: 27; R_0603_1608Metric_Pad0.98x0.95mm_HandSolder; mouser 603-RC0603FR-1327RL
SW1, SW2: SW_Push; SW_Push_1P1T_NO_Vertical_Wuerth_434133025816; MPN 434133025816; mouser 710-434133025816
U1: W25Q128JVS; SOIC-8_5.3x5.3mm_P1.27mm; MPN W25Q128JVSIM TR; mouser 454-W25Q128JVSIMTR
U2: RP2350_60QFN; RP2350-QFN-60-1EP_7x7_P0.4mm_EP3.4x3.4mm_ThermalVias; mouser 358-SC1509
U3: WE-TVS-82400102; SOT-23-6; MPN 82400102; mouser 710-82400102
Y1: ABM8-272-T3; Crystal_SMD_3225-4Pin_3.2x2.5mm; Farnell 4331750

Connections:
+1V1: C5.1, C6.1, C7.1, C9.1, C10.1, L1.1, U2.6 (DVDD), U2.23 (DVDD), U2.39 (DVDD), U2.50 (VREG_FB)
+3V3: C1.1, C2.1, C11.1, C12.1, C13.1, C14.1, C15.1, C16.1, C17.1, C18.1, R4.1, U1.8 (VCC), U2.1 (IOVDD), U2.11 (IOVDD), U2.20 (IOVDD), U2.30 (IOVDD), U2.38 (IOVDD), U2.44 (ADC_AVDD), U2.45 (IOVDD), U2.49 (VREG_VIN), U2.53 (USB_OTP_VDD), U2.54 (QSPI_IOVDD); also elsewhere on the board
+15V: D1.1 (K); also elsewhere on the board
/display/CHA_A: U2.7 (GPIO4); also elsewhere on the board
/display/CHA_B: U2.8 (GPIO5); also elsewhere on the board
/display/OLED_CS: U2.13 (GPIO9); also elsewhere on the board
/display/OLED_DC: U2.10 (GPIO7); also elsewhere on the board
/display/OLED_RST: U2.12 (GPIO8); also elsewhere on the board
/display/OLED_SCK: U2.14 (GPIO10); also elsewhere on the board
/display/OLED_SDO: U2.15 (GPIO11); also elsewhere on the board
/display/PUSH_BT_ENC: U2.9 (GPIO6); also elsewhere on the board
/display/RGB_led: U2.5 (GPIO3); also elsewhere on the board
/mcu_rp2354a/FLASH_SS: R5.1, U1.1 (~CS), U2.60 (QSPI_SS)
/mcu_rp2354a/GPIO0: U2.2 (GPIO0); also elsewhere on the board
/mcu_rp2354a/GPIO1: U2.3 (GPIO1); also elsewhere on the board
/mcu_rp2354a/GPIO2: U2.4 (GPIO2); also elsewhere on the board
/mcu_rp2354a/GPIO12: U2.16 (GPIO12); also elsewhere on the board
/mcu_rp2354a/GPIO13: U2.17 (GPIO13); also elsewhere on the board
/mcu_rp2354a/GPIO14: U2.18 (GPIO14); also elsewhere on the board
/mcu_rp2354a/GPIO15: U2.19 (GPIO15); also elsewhere on the board
/mcu_rp2354a/GPIO16: U2.27 (GPIO16); also elsewhere on the board
/mcu_rp2354a/GPIO17: U2.28 (GPIO17); also elsewhere on the board
/mcu_rp2354a/GPIO18: U2.29 (GPIO18); also elsewhere on the board
/mcu_rp2354a/GPIO19: U2.31 (GPIO19); also elsewhere on the board
/mcu_rp2354a/GPIO20: U2.32 (GPIO20); also elsewhere on the board
/mcu_rp2354a/GPIO21: U2.33 (GPIO21); also elsewhere on the board
/mcu_rp2354a/GPIO22: U2.34 (GPIO22); also elsewhere on the board
/mcu_rp2354a/GPIO23: U2.35 (GPIO23); also elsewhere on the board
/mcu_rp2354a/GPIO24: U2.36 (GPIO24); also elsewhere on the board
/mcu_rp2354a/GPIO25: U2.37 (GPIO25); also elsewhere on the board
/mcu_rp2354a/GPIO26_ADC0: U2.40 (GPIO26_ADC0); also elsewhere on the board
/mcu_rp2354a/GPIO27_ADC1: U2.41 (GPIO27_ADC1); also elsewhere on the board
/mcu_rp2354a/GPIO28_ADC2: U2.42 (GPIO28_ADC2); also elsewhere on the board
/mcu_rp2354a/GPIO29_ADC3: U2.43 (GPIO29_ADC3); also elsewhere on the board
/mcu_rp2354a/QSPI_SCLK: U1.6 (CLK), U2.56 (QSPI_SCLK)
/mcu_rp2354a/QSPI_SD0: U1.5 (DI(IO0)), U2.57 (QSPI_SD0)
/mcu_rp2354a/QSPI_SD1: U1.2 (DO(IO1)), U2.59 (QSPI_SD1)
/mcu_rp2354a/QSPI_SD2: U1.3 (IO2), U2.58 (QSPI_SD2)
/mcu_rp2354a/QSPI_SD3: U1.7 (IO3), U2.55 (QSPI_SD3)
/mcu_rp2354a/RUN: SW2.2, U2.26 (RUN)
/mcu_rp2354a/SWCLK: U2.24 (SWCLK)
/mcu_rp2354a/SWD: U2.25 (SWD)
/mcu_rp2354a/USB1_D+: R7.1, U3.1
/mcu_rp2354a/USB1_D-: R8.1, U3.3
/mcu_rp2354a/USB_D+: J1.A6 (D+), J1.B6 (D+), U3.6
/mcu_rp2354a/USB_D-: J1.A7 (D-), J1.B7 (D-), U3.4
/mcu_rp2354a/VREG_AVDD: C8.1, R4.2, U2.46 (VREG_AVDD)
/mcu_rp2354a/VREG_LX: L1.2, U2.48 (VREG_LX)
/mcu_rp2354a/XIN: C3.1, U2.21 (XIN), Y1.1
/mcu_rp2354a/XOUT: R6.1, U2.22 (XOUT)
/mcu_rp2354a/~USB_BOOT: R5.2, SW1.2
GND: C1.2, C2.2, C3.2, C4.2, C5.2, C6.2, C7.2, C8.2, C9.2, C10.2, C11.2, C12.2, C13.2, C14.2, C15.2, C16.2, C17.2, C18.2, H1.1, H2.1, H3.1, H4.1, J1.A1 (GND), J1.A12 (GND), J1.B1 (GND), J1.B12 (GND), J1.S1 (SHIELD), R1.2, R2.1, R3.2, SW1.1, U1.4 (GND), U2.47 (VREG_PGND), U2.61 (GND), U3.2, Y1.2, Y1.4; also elsewhere on the board
unnamed: C4.1, R6.2, Y1.3
unnamed: J1.A5 (CC1), R1.1
unnamed: J1.B5 (CC2), R2.2
unnamed: R3.1, SW2.1
unnamed: R8.2, U2.51 (USB_DM)
unnamed: R7.2, U2.52 (USB_DP)
VBUS: D1.2 (A), J1.A4 (VBUS), J1.A9 (VBUS), J1.B4 (VBUS), J1.B9 (VBUS), U3.5

Notes on the sheet:
12MHz Crystal
USB-C
- change the usb to to usb-c [done] - review back how the UCB C voltage supply are connected, since the main input is 15V [done]
Flash
Make sure R7 and R8 are close to RP2350

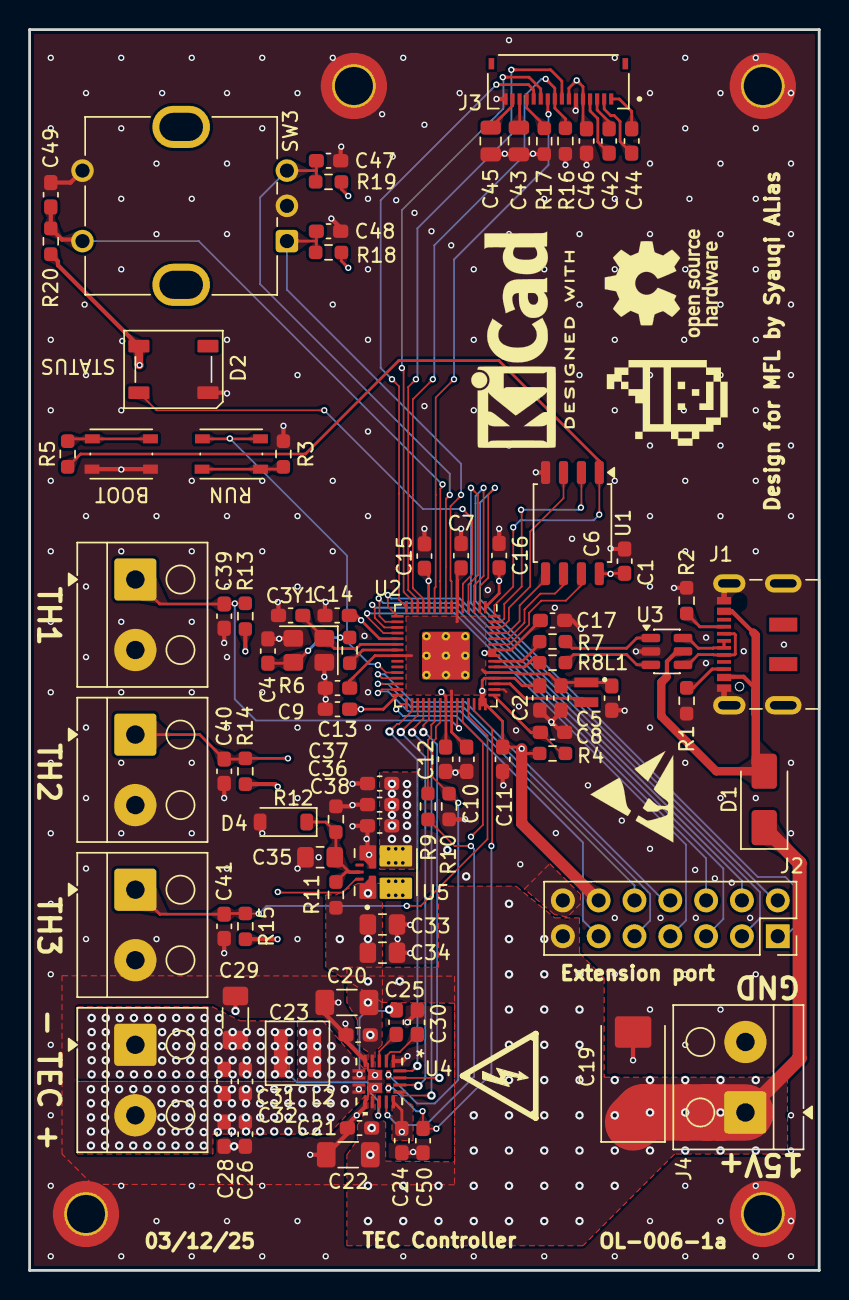
[picture p30: board pico_peltier.kicad_pcb from above]

Board: 4 copper layers, 56.0 x 88.0 mm, 94 parts (0 on the bottom side), 71 nets.
