syauqi-alias/pico-peltier/(commit log)

2025-12-04 entire project
    [3v3_psu.kicad_sch, 630-DC3145A_REV3_DESIGN_LAYOUT.PCB, 710-DC3145A_REV3_PCA_SCHEMATIC.DSN, 715-DC3145A_REV3_WEB_BOM.XLSX, display.kicad_sch, mcu_rp2354a.kicad_sch, peltier_cont.kicad_sch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]
2025-12-04 finalising again
    [mcu_rp2354a.kicad_sch]
2025-12-10 update all
    [3v3_psu.kicad_sch, pico_peltier.kicad_pcb]
2025-12-11 final update before fab
    [mcu_rp2354a.kicad_sch, pico_peltier.kicad_pcb]
2025-12-11 Add image to README for prototype visualization
2025-12-16 fix silkscreen
    [pico_peltier.kicad_pcb]
